mrrys00/eng-thesis-autonomous-mobile-robot/README.md

# Autonomous Mobile Robot

Autonomous mobile robot based on the Miabot Pro platform and a single-board computer

## External resources

- [Hokuyo scanner library](https://github.com/pasuder/hokuyo-python-lib/tree/master)
