mrrys00/eng-thesis-autonomous-mobile-robot/3d-model/README.md

# Prepare 3D models manual




## Required software

* [Blender **v3.5.1** (or higher)](https://www.blender.org/download/)
* [Ultimaker Cura **v5.0.0** (or higher)](https://ultimaker.com/software/ultimaker-cura/)

## Required devices (and more)

* 3D printer (configured!)
* Generic PLA filament

## Setup

### Blender (for new projects)

#### Memory & Limits

For Blender even selecting a face or a vertex is a step you can undo/redo. When you start a new project it's great to set up some limits high enough.

1. Go to `Edit > Prefecences`
2. Choose `System` tab
3. In `Memory & Limits` change the *Undo Steps* to 2048 (or higher) and *Undo Memory Limit* to 8192 (or higher)

    **Tip**: Feel free to select any number - you are not forced to use powers of 2

#### Units

Make sure you're working with meters. Work in millimeter scale is very annoying :disappointed:

### Ultimaker Cura

1. Select printer (in my case it's Anycubic 4Max)
2. Select filament (I suggest using PLA)

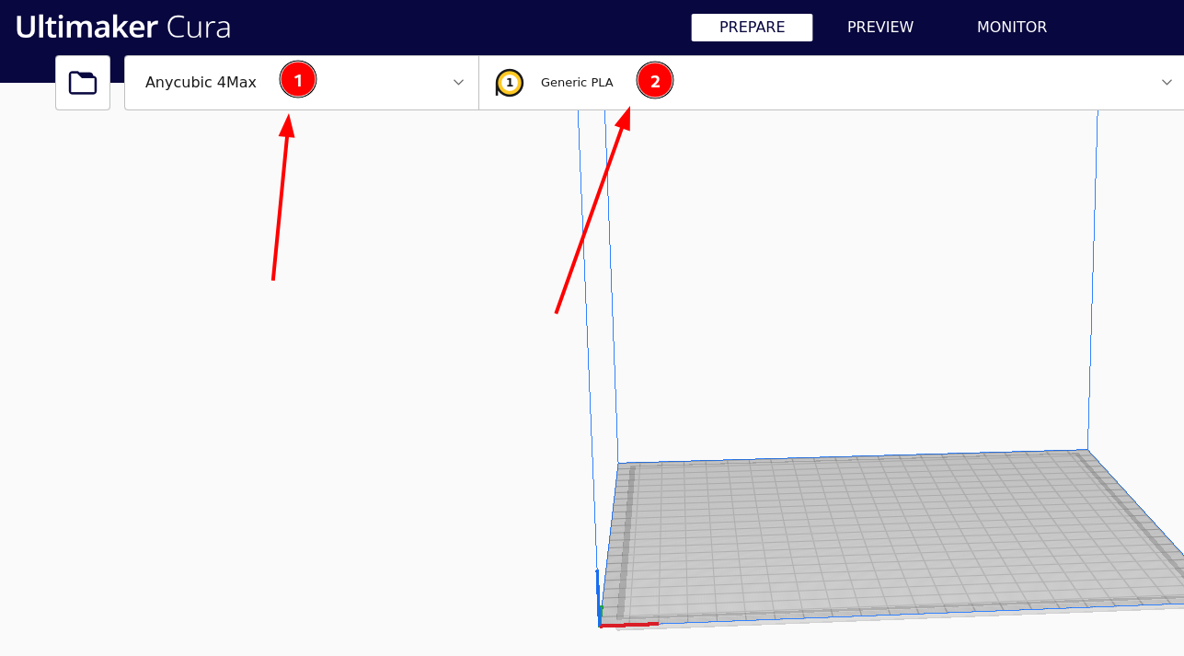
[picture p1: 3d-model/resources/cura-setup.png]
Ultimaker setup screen


## 3D preparing model tips

### New model

1. Start with one cube and do not add more objects

### Old model

1. Work on the copy of the model and increment version eg. `model-v2.blend` -> `model-v3.blend`

## Some 3D model requirements

1. No faces inside the model
2. Each face has **exactly** 4 vertices
3. No more than one vertex in one place. If more verticies have the same coordinates merge them

## Exporting STL/ OBJ/ … model

In Blender:

1. `File > Export > (choose .stl/ .obj/ …)`
2. Export

    *You probably don't even need to change the model scale*

## Preparing .gcode for 3D printer

In Ultimaker Cura

1. `File > Open File(s)`
2. Choose your model
3. Change model properties
    * (1) support **required**
    * (2) adhesion *optional*
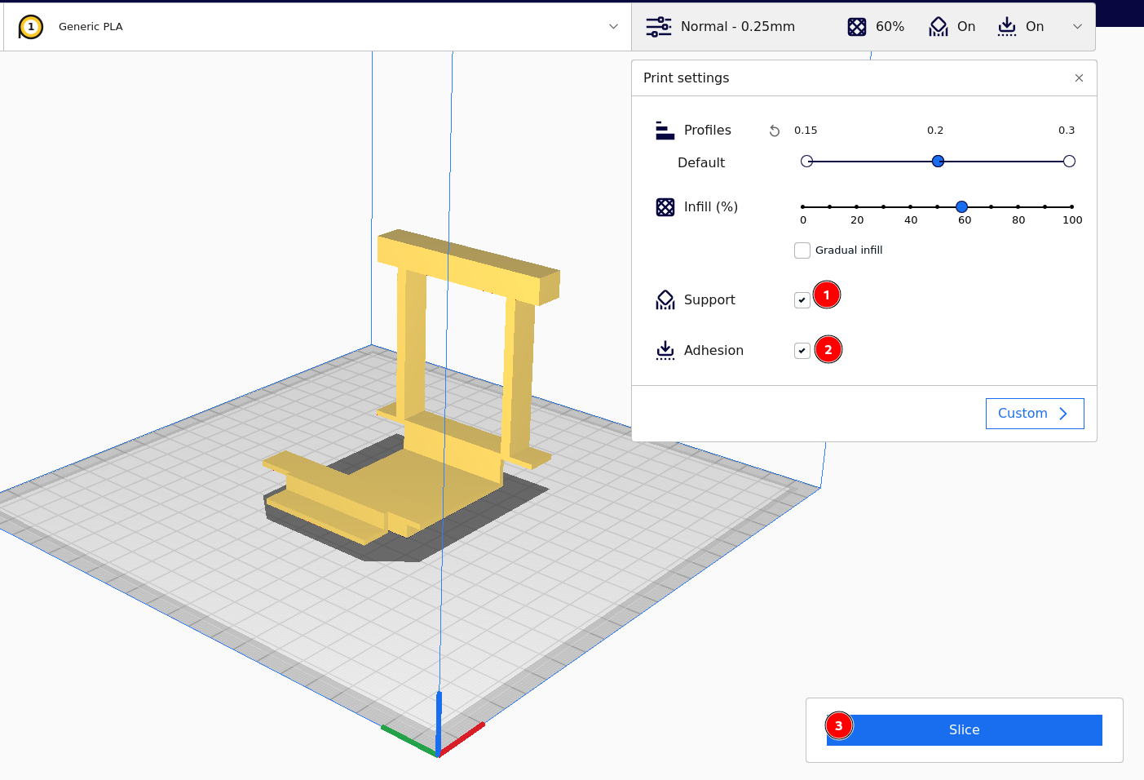
[picture p2: 3d-model/resources/cura-print-1.png]
Ultimaker print screen

4. (3) Click `Slice`
5. Check:
    * (1) visually if model seems correct
    * (2) print time
    * (3) number of layers
    * (4) model size after print
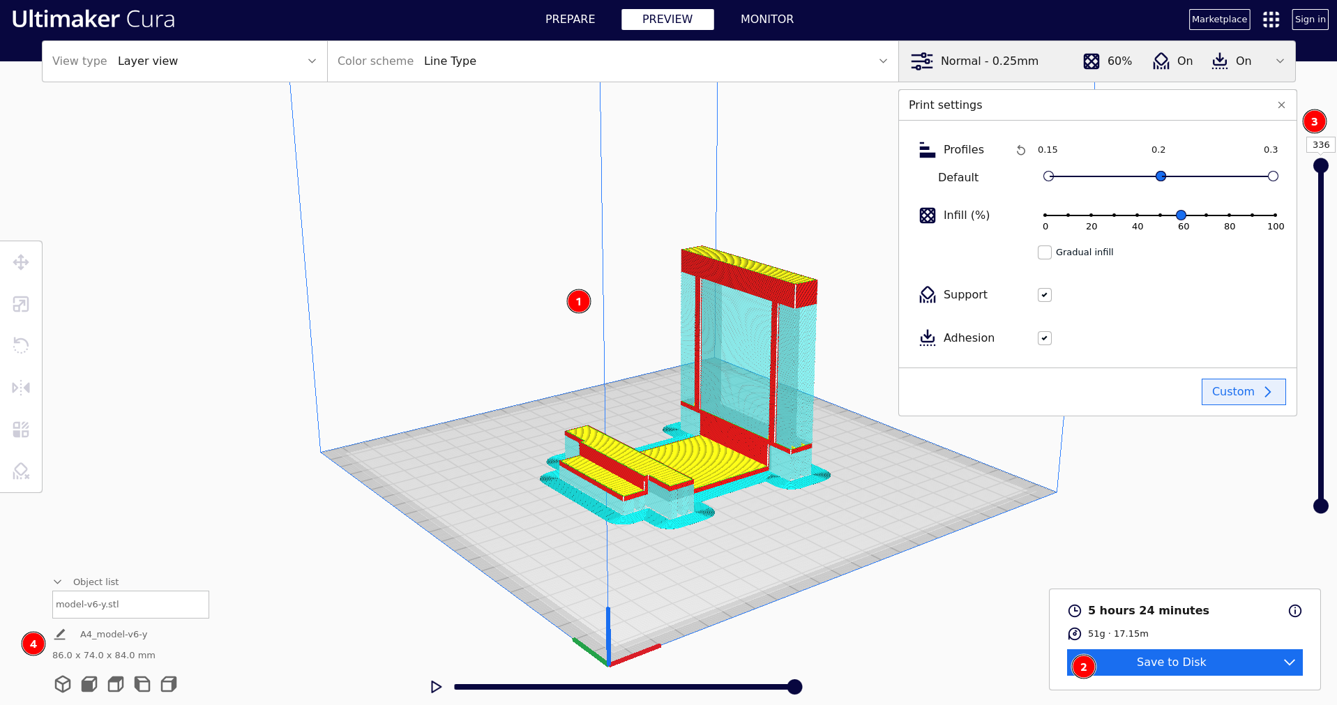
[picture p3: 3d-model/resources/cura-print-2.png]
Ultimaker print screen 2

6. `Save to Disk` - choose disk you want to save to
