mrrys00/eng-thesis-autonomous-mobile-robot/3d-model/models/model-v13.stl

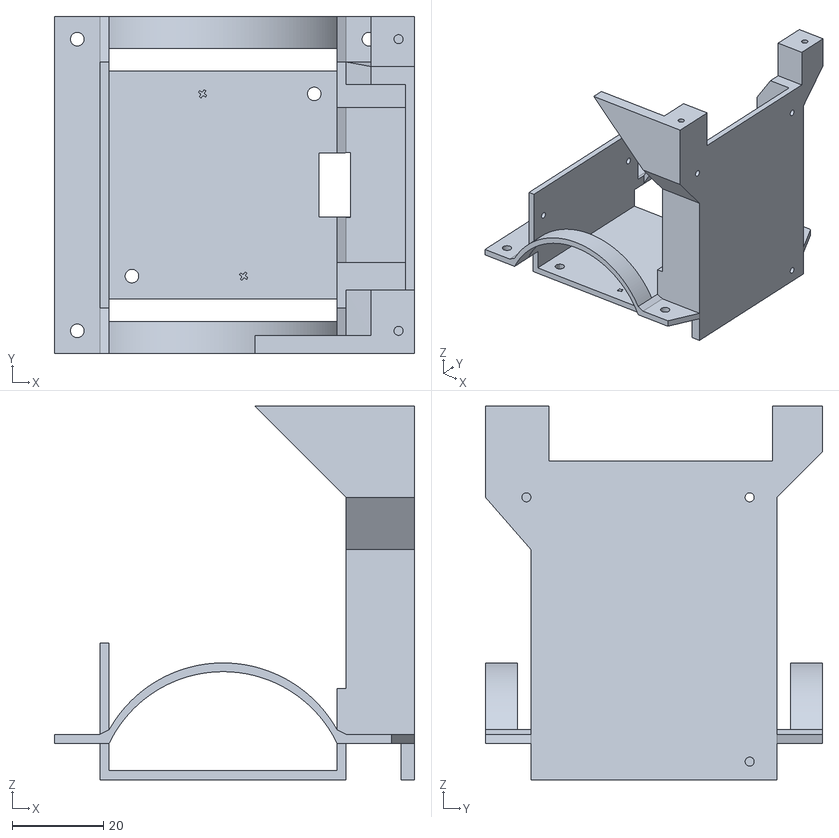
[picture p6: CAD file, 2023-12-27]
3d-model/models/model-v13.stl
79.0 x 74.0 x 82.0
