mrrys00/eng-thesis-autonomous-mobile-robot/3d-model/models/model-v6-2.stl

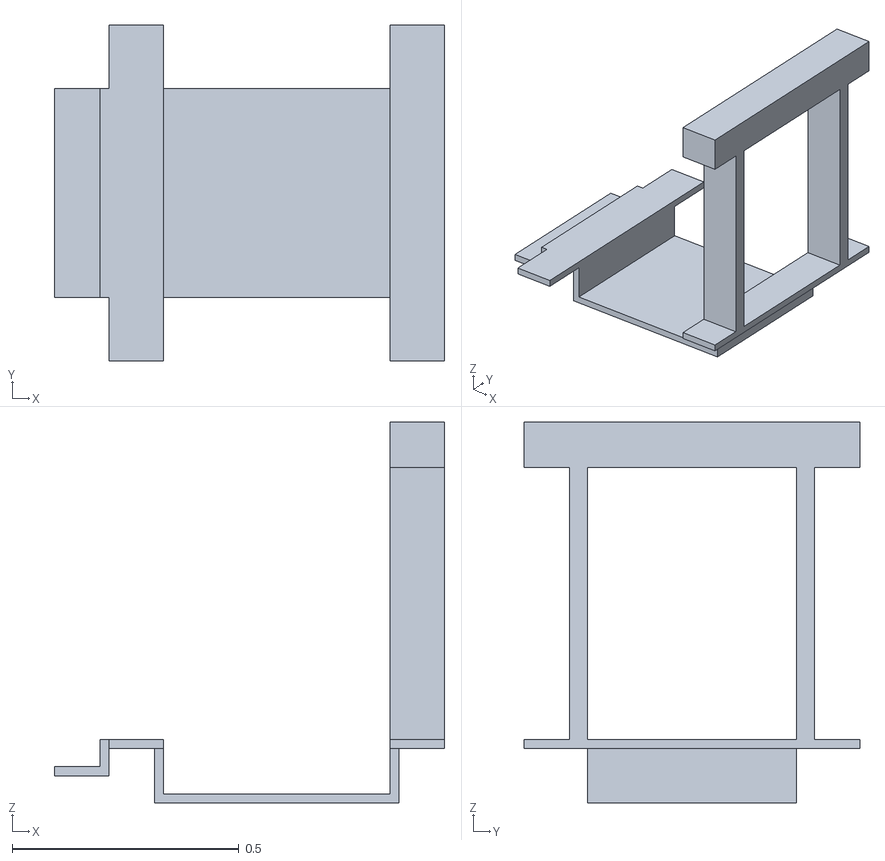
[picture p7: CAD file, 2023-10-05]
3d-model/models/model-v6-2.stl
0.86 x 0.74 x 0.84
