mrrys00/eng-thesis-autonomous-mobile-robot/3d-model/models/URG-04LX-UG01.dxf

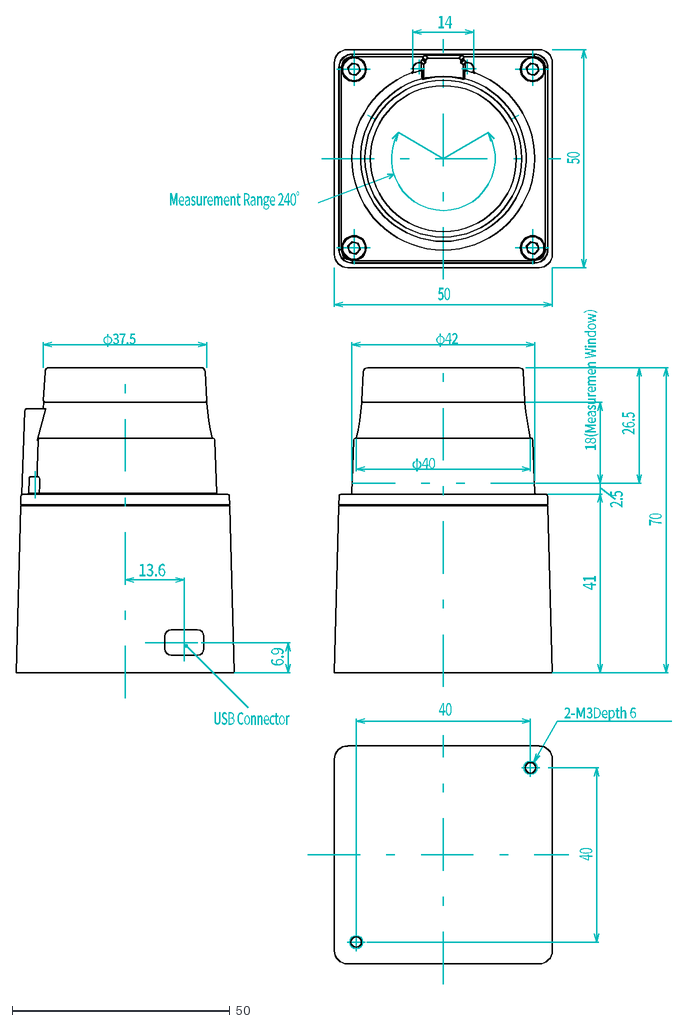
[picture p8: CAD file, 2023-10-05]
3d-model/models/URG-04LX-UG01.dxf
70
41
2.5
26.5
2-Ｍ3 Depth 6
φ40
φ42
18(Measuremen Window）
50
Measurement Range 240ﾟ
14
φ37.5
13.6
6.9
USB Connector
40
