mrrys00/eng-thesis-autonomous-mobile-robot/3d-model/models/18650-v13.stl

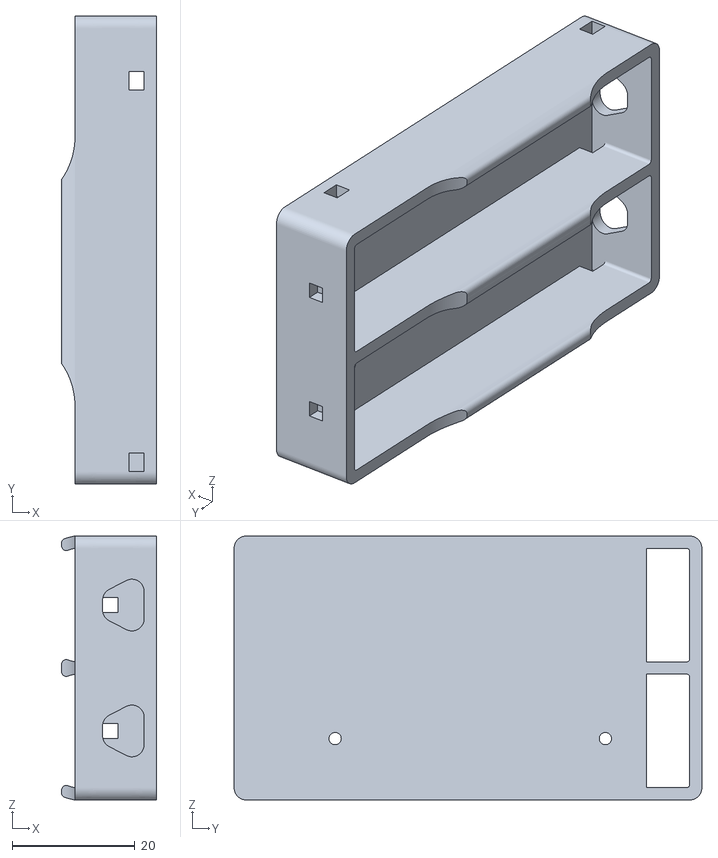
[picture p9: CAD file, 2023-12-27]
3d-model/models/18650-v13.stl
15.5 x 76.2 x 43.0
