mrrys00/eng-thesis-autonomous-mobile-robot/3d-model/models/18650_X2.stl

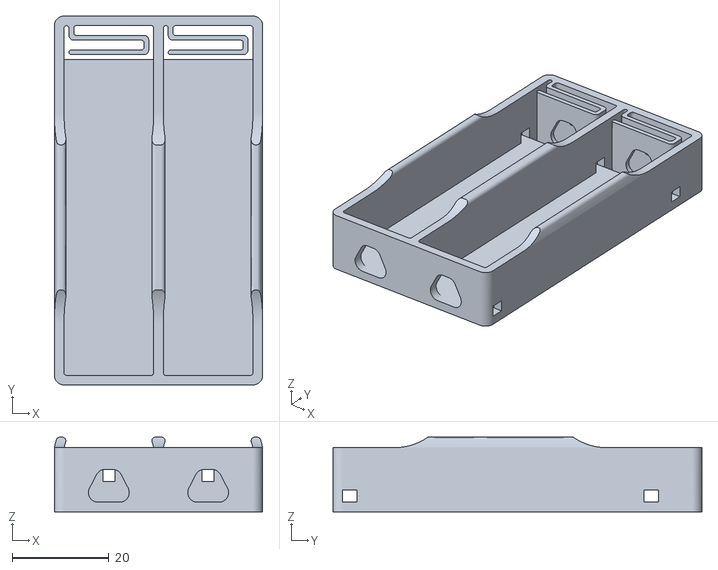
[picture p10: CAD file, 2023-10-29]
3d-model/models/18650_X2.stl
43.0 x 76.2 x 15.5
