mrrys00/eng-thesis-autonomous-mobile-robot/3d-model/models/model-v9.stl

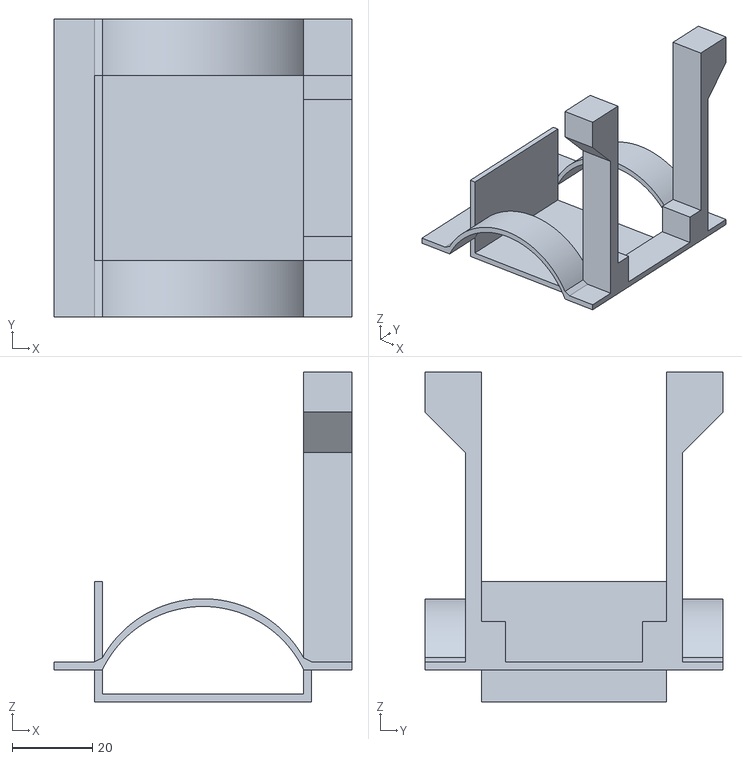
[picture p11: CAD file, 2023-10-29, an earlier design]
3d-model/models/model-v9.stl
74.0 x 74.0 x 82.0
