mrrys00/eng-thesis-autonomous-mobile-robot/3d-model/models/model-v10.stl

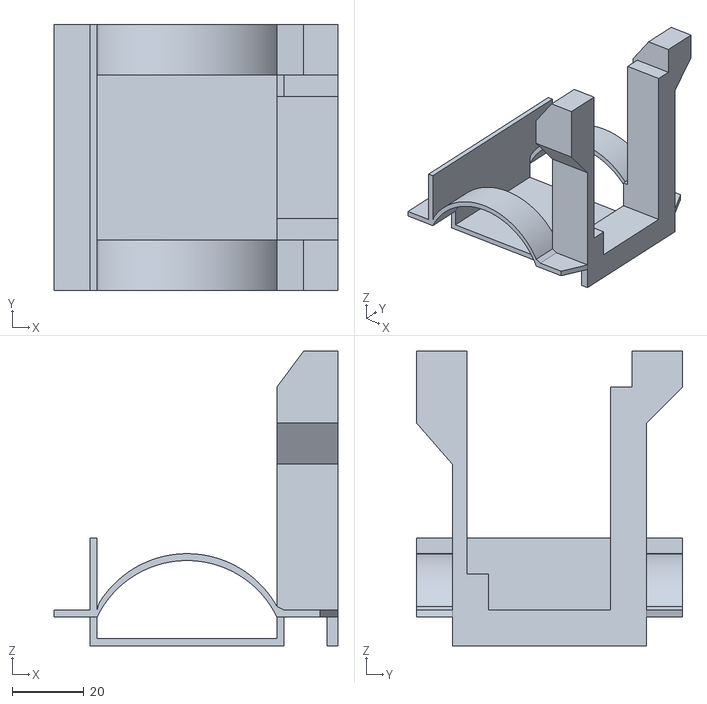
[picture p12: CAD file, 2023-10-29, an earlier design]
3d-model/models/model-v10.stl
79.0 x 74.0 x 82.0
