mrrys00/eng-thesis-autonomous-mobile-robot/(list of files, cad)

Other CAD files:
3d-model/models/model-v12.stl
3d-model/models/model-v11.stl
3d-model/models/model-v8.stl
3d-model/projects/model-v5.blend
3d-model/projects/model-v6.blend
