mrrys00/eng-thesis-autonomous-mobile-robot/build-instruction/README.md

# Build instruction




## Physical components

| **Component** | **Qty** | **Documentation** | **Shop** |
|---|---|---|---|
| Raspberry Pi 4B | 1 | [raspberrypi.com](https://www.raspberrypi.com/documentation/) | [botland.store](https://botland.com.pl/moduly-i-zestawy-raspberry-pi-4b/14647-raspberry-pi-4-model-b-wifi-dualband-bluetooth-4gb-ram-15ghz-5056561800349.html) |  |  |  |  |  |  |
| Hokuyo UGR 04LX | 1 | [hokuyo-aut.jp](https://www.hokuyo-aut.jp/search/single.php?serial=166) | *Discontinued* |  |  |  |  |  |  |
| Miabot Pro | 1 | *use repo docs* :wink: | *Discontinued* |  |  |  |  |  |  |
| Printed structure | 1 | - | *print yourself* |  |  |  |  |  |  |
| 18650 Li-Ion Samsung | 2 | [botland.store](https://botland.store/li-ion-batteries/10035-18650-li-ion-samsung-inr18650-25r-2500mah-5900000000176.html) | [botland.store](https://botland.store/li-ion-batteries/10035-18650-li-ion-samsung-inr18650-25r-2500mah-5900000000176.html) |  |  |  |  |  |  |
| MicroSD 32GB | 1 | - | [amazon.pl](https://www.amazon.pl/SAMSUNG-Endurance-microSDHC-monitoringu-MB-MJ32KA/dp/B0B1J64G4K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) |  |  |  |  |  |  |
| Cell Holder | 1 | - | [botland.store](https://botland.store/battery-holders/16517-cell-holder-for-2x-18650-battery-without-wires-5904422344603.html) |  |  |  |  |  |  |
| USBA-USBB | 1 | - | *cut unnecessary/ damaged one* |  |  |  |  |  |  |
| Logic level converter | 1 | - | [aliexpress.com](https://pl.aliexpress.com/i/32612366630.html?gatewayAdapt=glo2pol) |  |  |  |  |  |  |
| Step Down | 1 | [pololu.com](https://www.pololu.com/product/2111/specs) | [kamami.pl](https://kamami.pl/en/retired-products/195435-pololu-2110---pololu-step-down-voltage-regulator-d15v35f5s3.html) |  |  |  |  |  |  |
| USB C wire (solded to step down) | 1 | - | *cut unnecessary/ damaged one* |  |  |  |  |  |  |
| Signal wires |  | 4 colors, 30cm each |  |  |  |  |  |  |  |
| Power wires |  | 2 colors, 30cm each |  |  |  |  |  |  |  |

<!-- ## ROS nodes

| **** | **** | **** | **** | **** | **** | **** | **** | **** | **** |
|---|---|---|---|---|---|---|---|---|---|
|  |  |  |  |  |  |  |  |  |  |
|  |  |  |  |  |  |  |  |  |  |
|  |  |  |  |  |  |  |  |  |  |
|  |  |  |  |  |  |  |  |  |  |
|  |  |  |  |  |  |  |  |  |  |
|  |  |  |  |  |  |  |  |  |  |
|  |  |  |  |  |  |  |  |  |  |
|  |  |  |  |  |  |  |  |  |  |
|  |  |  |  |  |  |  |  |  |  |

## Other software

| **** | **** | **** | **** | **** | **** | **** | **** | **** | **** |
|---|---|---|---|---|---|---|---|---|---|
|  |  |  |  |  |  |  |  |  |  |
|  |  |  |  |  |  |  |  |  |  |
|  |  |  |  |  |  |  |  |  |  |
|  |  |  |  |  |  |  |  |  |  |
|  |  |  |  |  |  |  |  |  |  |
|  |  |  |  |  |  |  |  |  |  |
|  |  |  |  |  |  |  |  |  |  |
|  |  |  |  |  |  |  |  |  |  |
|  |  |  |  |  |  |  |  |  |  | -->
