mrrys00/eng-thesis-autonomous-mobile-robot/results/frames_2023-12-23_18.12.47.pdf

view_frames Result

Recorded at time: 1703351567.4090333

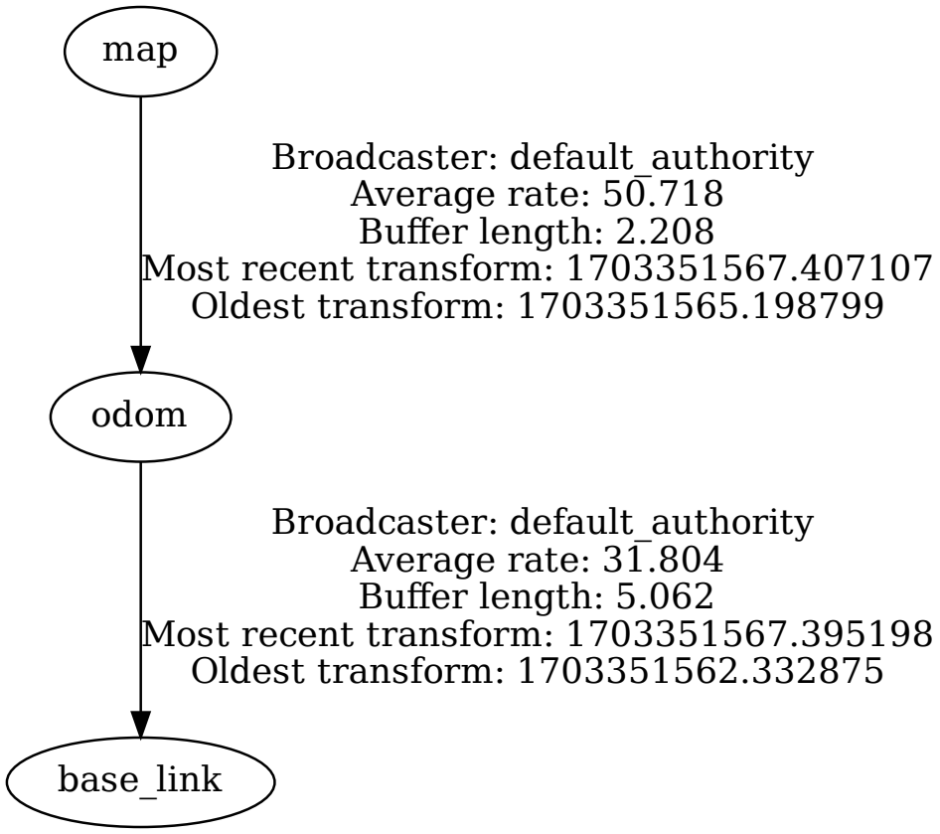
[picture p13: figure]
odom; base_link; Broadcaster: default_authority Average rate: 31.804 Buffer length: 5.062 Most recent transform: 1703351567.395198 Oldest transform: 1703351562.332875; map; Broadcaster: default_authority Average rate: 50.718 Buffer length: 2.208 Most recent transform: 1703351567.407107 Oldest transform: 1703351565.198799
