mrrys00/eng-thesis-autonomous-mobile-robot/results/rosgraph.png

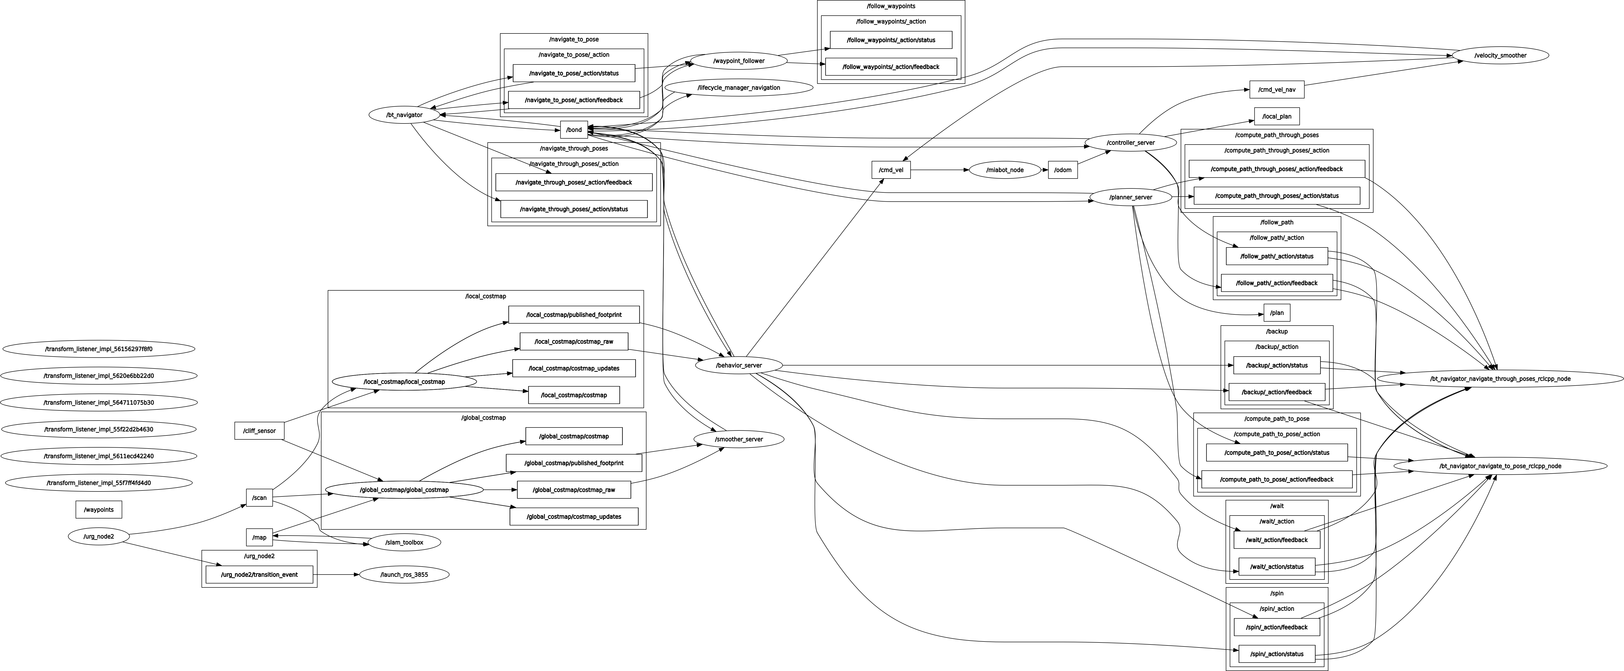
results/rosgraph.png
