mrrys00/eng-thesis-autonomous-mobile-robot/results/rosgraph_useful.png

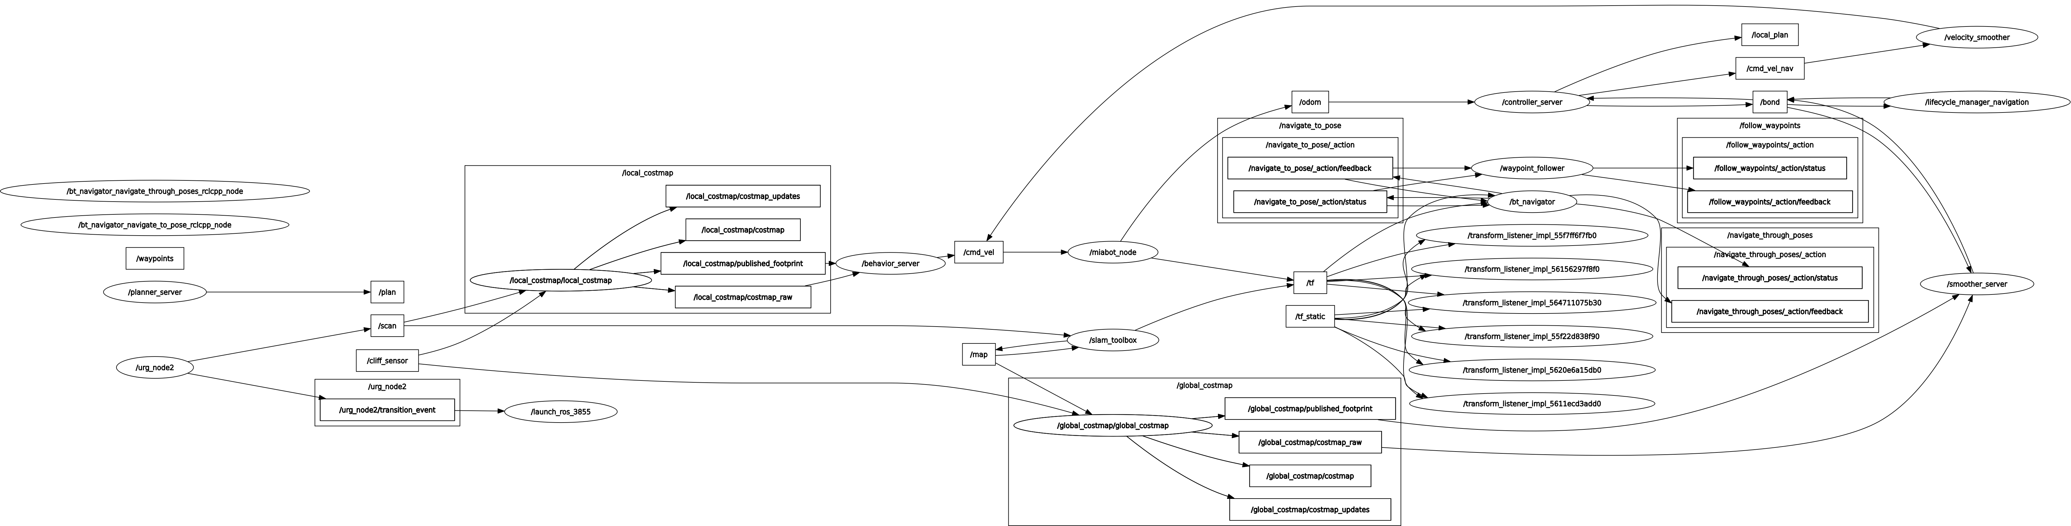
results/rosgraph_useful.png
