mrrys00/eng-thesis-autonomous-mobile-robot/results/Screenshot from 2023-12-23 18-06-59.png

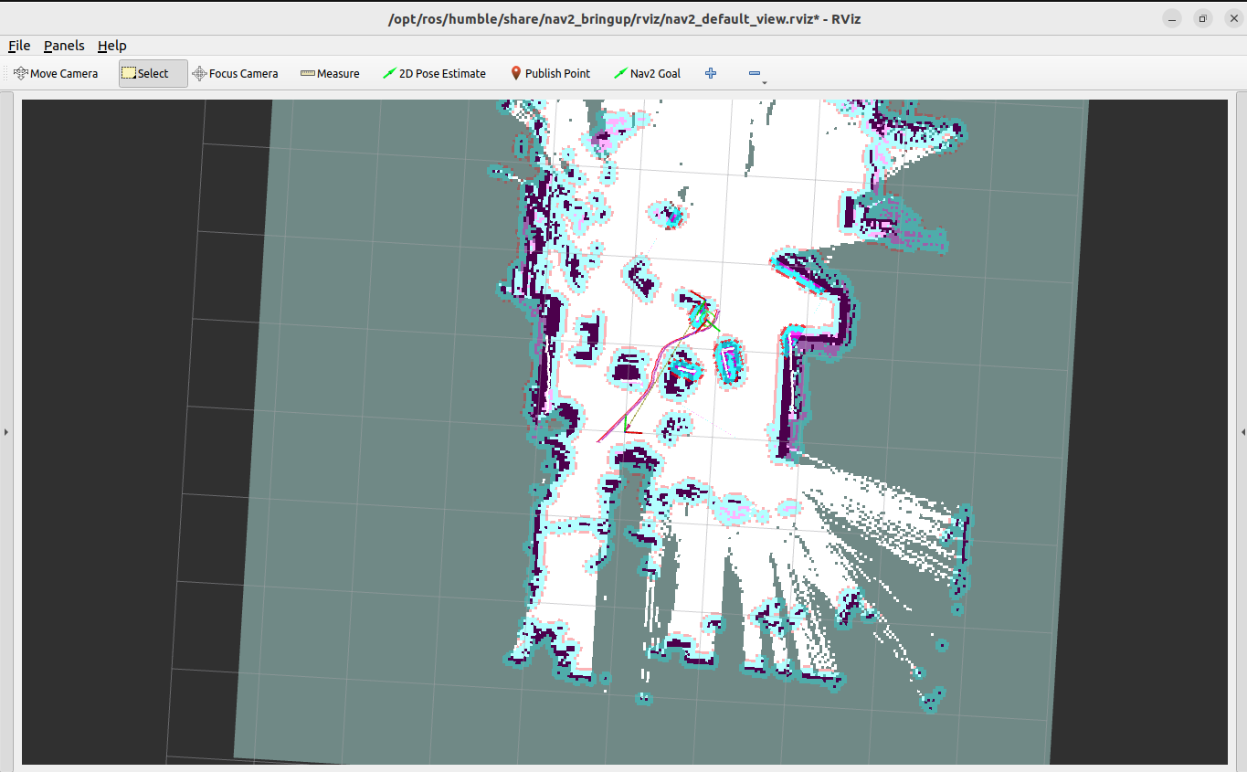
results/Screenshot from 2023-12-23 18-06-59.png
