mrrys00/eng-thesis-autonomous-mobile-robot/(commit log)

2023-08-06 +v0.0.1 setup wire communication between miabot and RPi
2023-08-08 +init model v5
    [model-v5.blend]
2023-08-09 +finished and exported model v6
    [model-v6.blend, model-v6.stl]
2023-08-10 +readme, update repo struct
    [model-v5.blend, model-v6-2.stl, model-v6.blend, model-v6.stl]
2023-08-11 +urg model for better modeling scale
    [URG-04LX-UG01.dxf]
2023-10-09 add model v10
    [model-v10.stl]
2023-10-13 add battery case model
    [18650_X2.stl]
2023-10-25 quick fix files
    [model-v11.stl]
2023-12-17 +battery holder to project
2023-12-27 Last model (#9)
    * +battery holder to project
    * v12
    * dziury na śrubki
    * +final models
    ---------
    [18650-v13.stl, model-v13.stl]
2023-12-28 Robot autonomous move v2 (#7)
    * +run working simulation
    * + template for tests
    * + some commands
    * +rpi version
    * +scp info, remove deprecated node
    * +some nodes
    * miabot node draft
    * MiabotNode command translation maybe works
    * fix node build
    * *update package info
    * update package info, update node
    * prepare commands to test
    * *quick fixes
    * +really helpful commands
    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
    [main.py, miabot_node.py]
2024-01-06 Launch description (#8)
    * +cmd_vel scaling to miabot
    * +odom and position
    * +improve time, +max velocity
    * +changes in config
    * +useful commands
    * +new node version
    * something useful
    * +some info how to change
    * +run descr
    * new node code
    * *update run commands
    * *currently best nod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
    [miabot_node.py, send_commands.py, simple_terminal.py]
